andreasbrett/OVLP/(threads)

Thread 2 (2023-11-12):

Lag and/or missed keystrokes

aikiharp, 2023-11-12:
Hi, I built this pedal this week. Thank you so much for the layout and instructions!

I'm having a problem on YouTube for Chrome on Mac Sonoma. Sometimes the footswitches elicit an immediate response from YouTube, sometimes there's a delay in response, and sometimes there's no response at all. I'm new to Arduino and GreaseMonkey, so I'm not sure how to troubleshoot.

I wonder if the GreaseMonkey script is causing lag? It appears all the functions in your design are covered by native YouTube keyboard shortcuts, except looping. I wonder if the pedal would bebe more responsive by sending the YouTube native keystrokes directly instead of via GreaseMonkey? I'd have to find a solution for the looping function though.

Any other ideas about the source of lag and/or missed keystrokes?

Thank you again for the project. It was fun to build.  I'm surprised I'm the first to post here since it seems like something super useful.

andreasbrett, 2023-11-12:
Thanks for the feedback. Great to finally see someone using it. I haven't tested OVLP with a Mac to be honest but it's great to hear that it (at least partially) works. There are 2 things you could try:

1) extend the timings for a short press here: https://github.com/andreasbrett/OVLP/blob/414867798e9a0afab297b07d95b6abdcb45052e1/Arduino/OVLP/OVLP.ino#L32

2) modify the greasemonkey script and comment out the following if-block. This will keep the native youtube key map for play. If that fixes the issue for the play button, it is the greasemonkey script and I will need to debug. I don't think so though. https://github.com/andreasbrett/OVLP/blob/414867798e9a0afab297b07d95b6abdcb45052e1/Tampermonkey/OVLP.user.js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

ImCoKeMaN, 2023-11-23:
Just letting you know someone else uses this!  I use it on PC and haven't had the missed key issues, I did a few adjustments to use internal arduino resistors and changed a key combo or 2 due to conflicts, but it's been working great for youtube videos.

ImCoKeMaN, 2023-11-27:
I just knew my arduino had pullup resistors and didn't want to wire in additional components (didn't have enough resistors lying around either)  only a few changes are needed for it, but if you're not familiar might not be worth the change since the code/wiring/project was already documented fairly completely
sample edits:
pinMode(IN_pin_button, INPUT**_PULLUP**);
and reverse the high/low logic
if (currentState == **LOW**)   //instead of HIGH
and
 if (digitalRead(pin_bank) == **HIGH**) {

If you do want to change anything make sure you have it working first before throwing in additional variables to the troubleshooting =)

ImCoKeMaN, 2023-11-28:
Same function just in reverse resistor to ground is a pull down that's why I needed to make the code changes to adapt as well.

aikiharp, 2023-11-28:
@andreasbrett I think my problem is getting the duration for the short press in OVLP.ino to correctly match what my foot is doing, and vice-versa. It seems pretty sensitive to the timing--is there a way to set a range from 10ms to 50ms for the short press and 300-600ms for long press (or similar)?  Also, I don't use the midi function but I wired the switch in anyway. Any suggestions on what I could do with the other bank?

andreasbrett, 2023-12-05:
@aikiharp we could of course change the code to allow ranges of 10-50ms for short press and 300-600ms for long press but what happens with presses of 51-299ms duration? IMHO it's bad UX to have a gap between short and long press ranges.

Looking at my comment from back then, I think you might have gotten the wrong idea how short and long presses are distinguished in OVLP. A button needs to be pressed AT LEAST 30ms to be actually considered a button press. If it had been pressed for 30-449ms it is a short press. If it is 450ms or more it is a long press.
https://github.com/andreasbrett/OVLP/blob/414867798e9a0afab297b07d95b6abdcb45052e1/Arduino/OVLP/OVLP.ino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

Changing the parameters to 10 and 300 should roughly result in what you requested. I would not go as low as 10ms though as you won't be able to physically press that quickly (especially not with feet) and it increases risk of bouncing (see: https://docs.arduino.cc/built-in-examples/digital/Debounce). I chose 30ms which is already quite low considering the Arduino example uses 50ms.

andreasbrett, 2023-12-05:
To find good values you can set `logMessages` to `true` (see [here](https://github.com/andreasbrett/OVLP/blob/6d8ae96e3c8f0b29a78eafc8fcb712087c45f027/Arduino/OVLP/OVLP.ino#L34)) and watch the serial monitor in Arduino IDE. You should get valuable info how your button presses were interpreted. Use the latest code (published a minute ago) to also see timings like this:

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

aikiharp, 2023-12-06:
@andreasbrett This is great info, and very helpful! I enabled serial logging and there's some weirdness going on with the board and/or the switches:

```
---------------------------------------------
Serial interface initialized.
Initializing USB HID interface...
Initializing USB MIDI interface...
Initializing buttons...
Initialized button on pin 5
Initialized button on pin 6
Initialized button on pin 7
Initialized button on pin 8
Initialized button on pin 9
Initialized button on pin 10
Initialization done. Running loop now.
---------------------------------------------

Button press detected...
 - hold time = 0ms
 -> bounced. ignoring.

Button press detected...
 - hold time = 0ms
 -> bounced. ignoring.

Button press detected...
 - hold time = 0ms
 -> bounced. ignoring.

Button press detected...
 - hold time = 5ms
 -> bounced. ignoring.

Button press detected...
 - hold time = 6ms
 -> bounced. ignoring.

Button press detected...
 - hold time = 7ms
 -> bounced. ignoring.

Button press detected...
 - hold time = 6ms
 -> bounced. ignoring.

Button press detected...
 - hold time = 6ms
 -> bounced. ignoring.
Button press detected...
 - hold time = 15ms
 -> bounced. ignoring.

Button press detected...
 - hold time = 132ms
 - bank = 2
 - type = short
 - sending MIDI-PC#5
 - hold time = 114ms
 - bank = 2
 - type = short
 - sending MIDI-PC#3

Button press detected...
 - hold time = 8ms
 -> bounced. ignoring.
```

All of the ignored presses are without touching the switches. The 2nd to last is where I did press one of the switches and it's reading the output. Mechanical problem? Next step will be to test all the switches for continuity to see if one or more is sending these "ghost presses."

Any other troubleshooting advice is greatly appreciated.

andreasbrett, 2023-12-08:
Awesome! Glad this got solved and we now know OVLP works as intended on MacOS as well!

Closed 2023-12-08.

Thread 3 (2024-11-08):

Doc Enhancement Request

allan-jp, 2024-11-08:
Greetings,

Firstly, thank you for your work on this project! As a complete newbie to Arduino builds, I didn't realize the breadboard came with adhesive backing. It might be helpful for others in the future to explicitly call out the breadboard will attach directly to enclosure. Pedal works great!

Thanks again!

Closed 2025-02-14.
