andreasbrett/OVLP/(commit log)

2020-06-07 merge dev
    * stability improvements + modified pin mappings
    * bugfixes
    [OVLP.ino]
2020-06-14 introduced fullscreen button
2020-08-30 fix pin definition
